Normansrule/hydra-skywater130/docs/CAPACITY.md

# Expansion roadmap, and what each one needs from an FPGA

Generated by `tools/capacity.py` (run it after changing any estimate). Every
"measured" number came out of a tool in this repository or out of the
session-178 place-and-route table; every "est" is an engineering estimate with
its basis stated in the source.

## The conversion, and why it is trustworthy enough to buy a board with

One design, the TT-A v2 tile, mapped three ways in this session:

| mapping | result | tool |
|---|---|---|
| sky130 standard cells | 28,183 cells / 194,647 um2 | yosys + abc |
| Lattice ECP5 LUT4 | 14,360 LUTs, 3,742 flops, 10 multipliers | yosys + nextpnr-ecp5 |
| Xilinx 7-series LUT6 | 7,539 LUTs, 12 DSP48 | yosys synth_xilinx |

So **0.51 ECP5 LUT4** or **0.27 Xilinx LUT6** per sky130 cell, for logic of
this shape. Wide datapaths (the P-256 units, the systolic array) map more
densely than this; register files map worse unless they become block RAM. It
is an order-of-magnitude answer: right for choosing hardware, wrong for
promising a utilisation figure.

| block | sky130 cells | ECP5-85F LUT4 | % of the board |
|---|---|---|---|
| ecdsa_top | 188,028 | 95,805 | 115% |
| tpu_top | 86,591 | 44,120 | 53% |
| mom_top (as the v2 tile) | 28,183 | 14,360 | 17% |
| core_pipe | 24,491 | 12,479 | 15% |
| core_mini | 9,923 | 5,056 | 6% |
| axis blocks (qenc, enc_theta, adc_capture, pwm_gen) | 2,600 | 1,325 | 2% |
| data RAM (flop array) (est) | 135,000 | 68,786 | 82% |

| expansion | sky130 cells (est) | ECP5-85F LUT4 | fits beside the tile? |
|---|---|---|---|

## The roadmap, block by block

| expansion | sky130 cells (est) | ECP5-85F LUT4 | fits beside the tile? |
|---|---|---|---|
| SHE CMAC path | 12,000 | 6,114 | yes |
| trng_source + trng_pool | 6,000 | 3,057 | yes |
| USB protocol engine + CDC | 20,000 | 10,191 | yes |
| engine crossbar (MOM to the engines) | 8,000 | 4,076 | yes |
| RAM ECC (SECDED) + bus fault unit | 10,000 | 5,095 | yes |
| dual-core lockstep | 25,000 | 12,738 | yes |
| RISC-V PMP | 8,000 | 4,076 | yes |
| voltage / temperature / glitch monitors | 4,000 | 2,038 | yes |
| watchdog to safe state | 1,000 | 510 | yes |
| multi-axis motor control, per extra axis | 3,000 | 1,529 | yes |
| 6 axes | 18,000 | 9,171 | yes |
| 20 axes (a humanoid) | 60,000 | 30,572 | yes |
| CAN-FD controller | 15,000 | 7,643 | yes |
| SecOC (authenticated frames) | 6,000 | 3,057 | yes |
| synchronised sensor capture | 4,000 | 2,038 | yes |
| SPI slave / host offload port | 5,000 | 2,548 | yes |
| absolute encoders (BiSS-C or SSI) | 6,000 | 3,057 | yes |
| authenticated debug unlock | 10,000 | 5,095 | yes |
| measured boot and attestation | 8,000 | 4,076 | yes |
| ML-KEM (Kyber) on the NTT | 40,000 | 20,381 | yes |
| PUF key provisioning | 5,000 | 2,548 | yes |
| fault-injection hardening on the signature path | 30,000 | 15,286 | yes |
| camera interface (DVP) | 8,000 | 4,076 | yes |
| Ethernet / TSN MAC | 60,000 | 30,572 | yes |
| GPU (already in the design, size not in the handoff) | 80,000 | 40,762 | yes |

"Fits beside the tile" means it fits in the 69,280 LUTs left over on an
ECP5-85F after the tile takes its 17%.

## The verdict on the ECP5-85F you are buying

board verdicts for the whole SoC:
  iCE40 UP5K (iCEBreaker)                 5,280 LUT4  needs  3279%  does NOT fit   $69
  Gowin GW2AR-18 (Tang Nano 20K)         20,736 LUT4  needs   835%  does NOT fit   $30, Amazon
  Artix-7 35T (Cmod A7)                  20,800 LUT6  needs   437%  does NOT fit   $99, DigiKey
  ECP5-85F (ECP5 Evaluation Board)       83,640 LUT4  needs   207%  does NOT fit   $99-159, DigiKey
  Artix-7 100T (Arty A7-100T)            63,400 LUT6  needs   143%  does NOT fit   ~$299
  Artix-7 200T (Nexys Video)            134,600 LUT6  needs    68%  fits   ~$599
  Kintex-7 325T (Genesys 2)             203,800 LUT6  needs    45%  fits   ~$1,200

**For the tile and for incremental work, the ECP5-85F is the right board.**
The tile uses 17% of it. Any single expansion below fits beside it, and most
pairs do. That is the loop you will actually run: bring a block across, run it
against real latencies, move to the next.

**For the whole SoC at once, it does not fit** — 173,145 LUT4 against 83,640.
Two ways forward, and the first is better:

1. **Feature-gated builds.** One target per subsystem: dispatcher plus cores,
   or crypto alone, or the motor axes plus CAN-FD. Each fits comfortably, each
   runs against real timing, and the gate is a plan file rather than a new
   board. This is also what the eventual chip wants, since a FEATURES register
   telling firmware which blocks exist is needed either way.
2. **A bigger board, when you need the whole thing in one image.** Nexys Video
   (Artix-7 200T, 134,600 LUT6, ~$599) takes the SoC as it stands at 68%.
   Genesys 2 (Kintex-7 325T, 203,800 LUT6, ~$1,200) takes it at 45% and leaves
   room for the roadmap below.

**Heavy duty — everything on this page at once.** The SoC plus the GPU plus the
safety, robotics and security expansions comes to roughly 620,000 cells, which
is about 166,000 LUT6: Genesys 2 at ~81%, nothing cheaper, and an UltraScale+
board if you want headroom. That is a real cost step, and it is the moment to
ask whether one image of everything is worth it, or whether the gated builds
plus the silicon itself answer the same questions.

## Two things that change the arithmetic

- **The data RAM is free on an FPGA.** 0.93 mm2 of flip-flops on the die
  becomes block RAM: the ECP5-85F has 208 x 18 kbit and the design uses none
  of it today. Every FPGA number here already assumes that swap.
- **ECDSA is the whole problem.** 188,028 cells is 55% of the current SoC and
  95,777 LUT4 on its own — more than the ECP5-85F has. Sharing the three
  `p256_modmul` instances down to one (the same arbitration pattern
  `ecdsa_top` already uses) is worth roughly 22,000 cells, and it is the
  single change that most improves both the die and the FPGA story.
