Normansrule/hydra-skywater130/docs/ISA_CPU.md

# CPU instruction set (RV32IM core)

GENERATED by `tools/isa/gen_cpu_isa.py`: every row below is what
`control_unit.sv` DOES when driven with that encoding, recorded by
`tools/isa/isa_probe_cpu.sv`. Do not edit; run the tool.
`make isa-check` fails if this file and the decoder disagree.

**Status: decoder only.** `engines/cpu/rtl/control_unit.sv` is a
control unit, not a CPU core, and nothing here is integrated with the
dispatcher; see `docs/verification/capability-matrix.md`.

55 encodings swept. Columns after `legal` are the decoder's
own control bundle: which ALU operation it selects, which immediate
format it takes, where the writeback comes from, and which unit runs
the instruction.

| instruction | opcode | funct3 | funct7 | legal | writes | ALU op | imm | writeback | unit |
|---|---|---|---|---|---|---|---|---|---|
| `LUI` | `0110111` | — | — | yes | rd | ALU_COPY_B | IMM_U | WB_ALU | ALU |
| `AUIPC` | `0010111` | — | — | yes | rd | ALU_ADD | IMM_U | WB_ALU | ALU |
| `JAL` | `1101111` | — | — | yes | rd | ALU_ADD | IMM_J | WB_PC4 | branch/jump |
| `JALR` | `1100111` | 000 | — | yes | rd | ALU_ADD | IMM_I | WB_PC4 | branch/jump |
| `BEQ` | `1100011` | 000 | — | yes | — | ALU_ADD | IMM_B | WB_ALU | branch/jump |
| `BNE` | `1100011` | 001 | — | yes | — | ALU_ADD | IMM_B | WB_ALU | branch/jump |
| `B?010` | `1100011` | 010 | — | yes | — | ALU_ADD | IMM_B | WB_ALU | branch/jump |
| `B?011` | `1100011` | 011 | — | yes | — | ALU_ADD | IMM_B | WB_ALU | branch/jump |
| `BLT` | `1100011` | 100 | — | yes | — | ALU_ADD | IMM_B | WB_ALU | branch/jump |
| `BGE` | `1100011` | 101 | — | yes | — | ALU_ADD | IMM_B | WB_ALU | branch/jump |
| `BLTU` | `1100011` | 110 | — | yes | — | ALU_ADD | IMM_B | WB_ALU | branch/jump |
| `BGEU` | `1100011` | 111 | — | yes | — | ALU_ADD | IMM_B | WB_ALU | branch/jump |
| `LB` | `0000011` | 000 | — | yes | rd | ALU_ADD | IMM_I | WB_MEM | load |
| `LH` | `0000011` | 001 | — | yes | rd | ALU_ADD | IMM_I | WB_MEM | load |
| `LW` | `0000011` | 010 | — | yes | rd | ALU_ADD | IMM_I | WB_MEM | load |
| `LBU` | `0000011` | 100 | — | yes | rd | ALU_ADD | IMM_I | WB_MEM | load |
| `LHU` | `0000011` | 101 | — | yes | rd | ALU_ADD | IMM_I | WB_MEM | load |
| `SB` | `0100011` | 000 | — | yes | — | ALU_ADD | IMM_S | WB_ALU | store |
| `SH` | `0100011` | 001 | — | yes | — | ALU_ADD | IMM_S | WB_ALU | store |
| `SW` | `0100011` | 010 | — | yes | — | ALU_ADD | IMM_S | WB_ALU | store |
| `ADDI` | `0010011` | 000 | — | yes | rd | ALU_ADD | IMM_I | WB_ALU | ALU |
| `SLTI` | `0010011` | 010 | — | yes | rd | ALU_SLT | IMM_I | WB_ALU | ALU |
| `SLTIU` | `0010011` | 011 | — | yes | rd | ALU_SLTU | IMM_I | WB_ALU | ALU |
| `XORI` | `0010011` | 100 | — | yes | rd | ALU_XOR | IMM_I | WB_ALU | ALU |
| `ORI` | `0010011` | 110 | — | yes | rd | ALU_OR | IMM_I | WB_ALU | ALU |
| `ANDI` | `0010011` | 111 | — | yes | rd | ALU_AND | IMM_I | WB_ALU | ALU |
| `SLLI` | `0010011` | 001 | 0000000 | yes | rd | ALU_SLL | IMM_I | WB_ALU | ALU |
| `SRLI` | `0010011` | 101 | 0000000 | yes | rd | ALU_SRL | IMM_I | WB_ALU | ALU |
| `SRAI` | `0010011` | 101 | 0100000 | yes | rd | ALU_SRA | IMM_I | WB_ALU | ALU |
| `ADD` | `0110011` | 000 | 0000000 | yes | rd | ALU_ADD | IMM_I | WB_ALU | ALU |
| `SUB` | `0110011` | 000 | 0100000 | yes | rd | ALU_SUB | IMM_I | WB_ALU | ALU |
| `SLL` | `0110011` | 001 | 0000000 | yes | rd | ALU_SLL | IMM_I | WB_ALU | ALU |
| `SLT` | `0110011` | 010 | 0000000 | yes | rd | ALU_SLT | IMM_I | WB_ALU | ALU |
| `SLTU` | `0110011` | 011 | 0000000 | yes | rd | ALU_SLTU | IMM_I | WB_ALU | ALU |
| `XOR` | `0110011` | 100 | 0000000 | yes | rd | ALU_XOR | IMM_I | WB_ALU | ALU |
| `SRL` | `0110011` | 101 | 0000000 | yes | rd | ALU_SRL | IMM_I | WB_ALU | ALU |
| `SRA` | `0110011` | 101 | 0100000 | yes | rd | ALU_SRA | IMM_I | WB_ALU | ALU |
| `OR` | `0110011` | 110 | 0000000 | yes | rd | ALU_OR | IMM_I | WB_ALU | ALU |
| `AND` | `0110011` | 111 | 0000000 | yes | rd | ALU_AND | IMM_I | WB_ALU | ALU |
| `MUL` | `0110011` | 000 | 0000001 | yes | rd | ALU_ADD | IMM_I | WB_ALU | mul/div |
| `MULH` | `0110011` | 001 | 0000001 | yes | rd | ALU_ADD | IMM_I | WB_ALU | mul/div |
| `MULHSU` | `0110011` | 010 | 0000001 | yes | rd | ALU_ADD | IMM_I | WB_ALU | mul/div |
| `MULHU` | `0110011` | 011 | 0000001 | yes | rd | ALU_ADD | IMM_I | WB_ALU | mul/div |
| `DIV` | `0110011` | 100 | 0000001 | yes | rd | ALU_ADD | IMM_I | WB_ALU | mul/div |
| `DIVU` | `0110011` | 101 | 0000001 | yes | rd | ALU_ADD | IMM_I | WB_ALU | mul/div |
| `REM` | `0110011` | 110 | 0000001 | yes | rd | ALU_ADD | IMM_I | WB_ALU | mul/div |
| `REMU` | `0110011` | 111 | 0000001 | yes | rd | ALU_ADD | IMM_I | WB_ALU | mul/div |
| `ECALL/EBREAK` | `1110011` | 000 | — | yes | — | ALU_ADD | IMM_I | WB_ALU | ALU |
| `CSRRW` | `1110011` | 001 | — | yes | rd | ALU_ADD | IMM_I | WB_CSR | CSR |
| `CSRRS` | `1110011` | 010 | — | yes | rd | ALU_ADD | IMM_I | WB_CSR | CSR |
| `CSRRC` | `1110011` | 011 | — | yes | rd | ALU_ADD | IMM_I | WB_CSR | CSR |
| `CSRRWI` | `1110011` | 101 | — | yes | rd | ALU_ADD | IMM_I | WB_CSR | CSR |
| `CSRRSI` | `1110011` | 110 | — | yes | rd | ALU_ADD | IMM_I | WB_CSR | CSR |
| `CSRRCI` | `1110011` | 111 | — | yes | rd | ALU_ADD | IMM_I | WB_CSR | CSR |
| `FENCE` | `0001111` | 000 | — | yes | — | ALU_ADD | IMM_I | WB_ALU | ALU |

## Encodings that should be rejected

These are probes, not instructions: each is an encoding RV32IM
does not define. What the decoder does with them is a security
property, because a corrupted or fuzzed instruction stream should
trap rather than execute something.

| probe | opcode | funct3 | funct7 | legal | decoded as |
|---|---|---|---|---|---|
| (bad opcode) | `1111111` | 000 | 0000000 | **no** | rejected |
| (bad load f3) | `0000011` | 111 | 0000000 | yes | load |
| (bad store f3) | `0100011` | 111 | 0000000 | yes | store |
| (bad op f7) | `0110011` | 000 | 0100001 | yes | ALU ALU_SUB |

**3 of 4 undefined encodings decode as legal.**
The decoder checks the opcode but not every reserved funct
field, so an unallocated encoding executes as its nearest
neighbour instead of raising an illegal-instruction trap. On a
chip whose purpose includes security this is worth a decision:
either tighten the decode, or state that trapping is the
privileged-mode monitor's job and test that it happens.
