Normansrule/hydra-skywater130/docs/img/atlas-architecture.dark.png

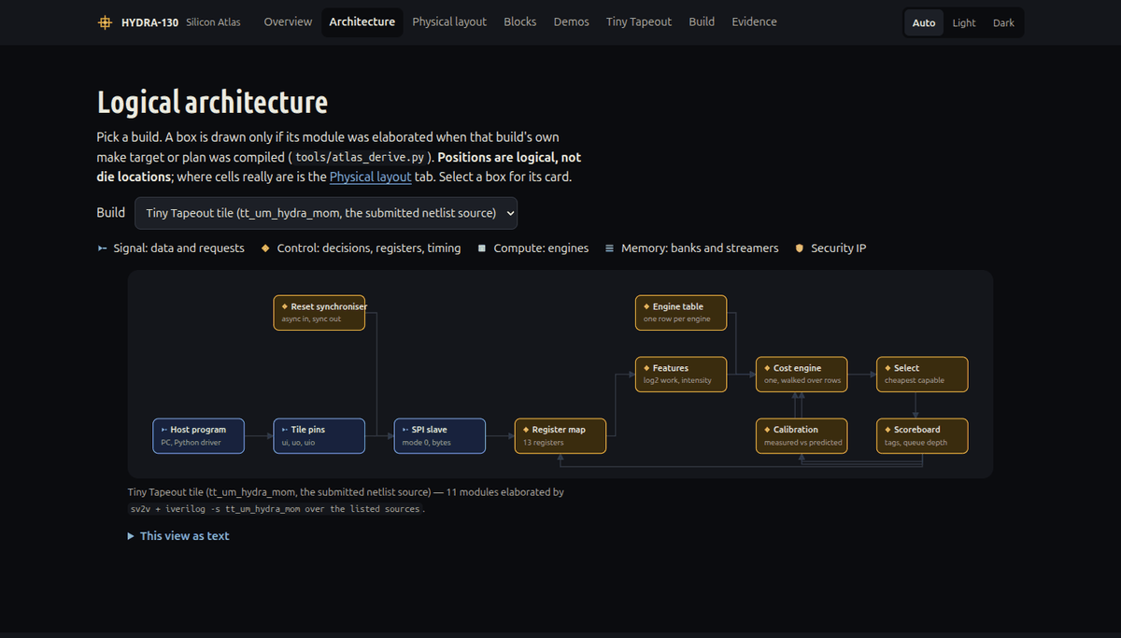
docs/img/atlas-architecture.dark.png
