Normansrule/hydra-skywater130/docs/img/atlas-architecture.png

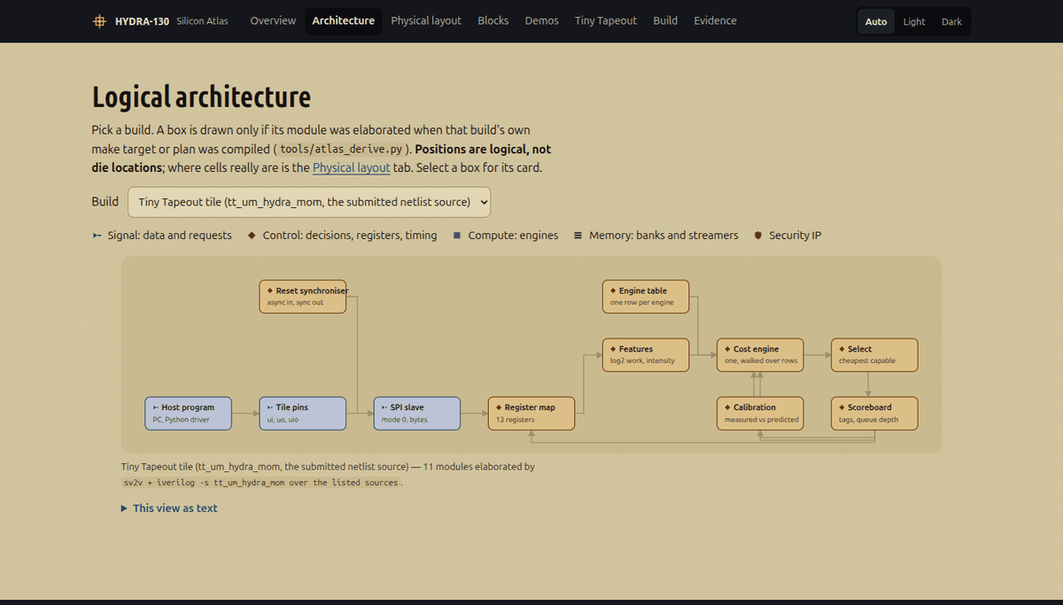
docs/img/atlas-architecture.png
