Normansrule/hydra-skywater130/docs/img/atlas-array.dark.png

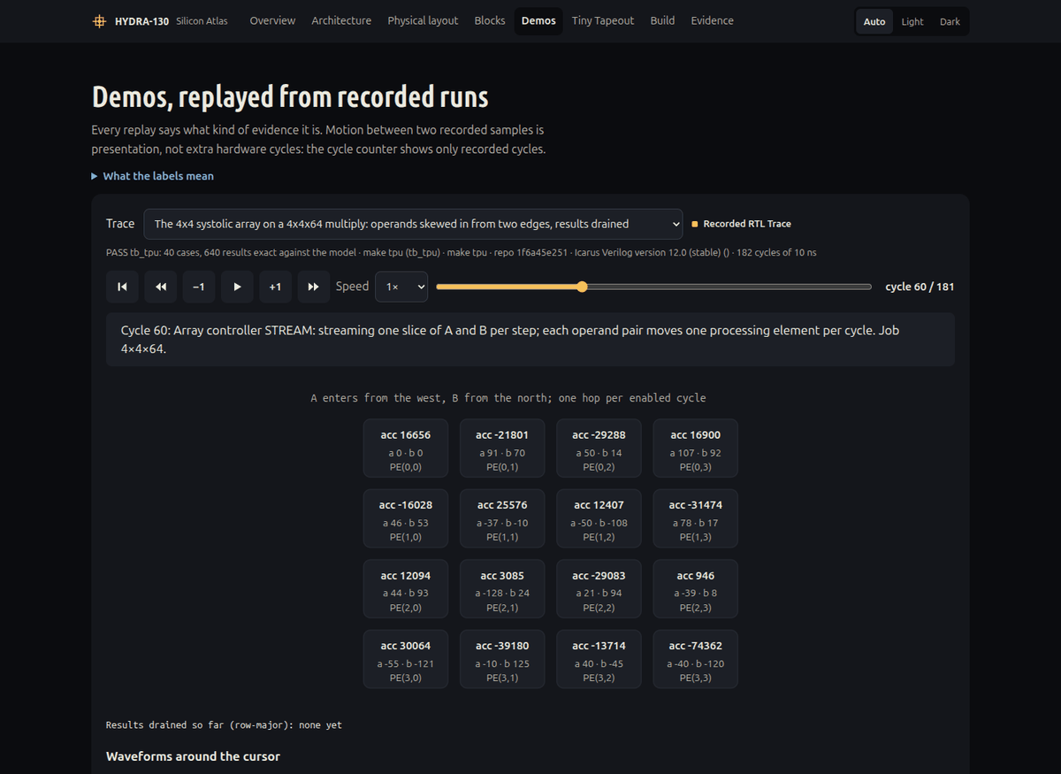
docs/img/atlas-array.dark.png
