Normansrule/hydra-skywater130/docs/img/atlas-array.png

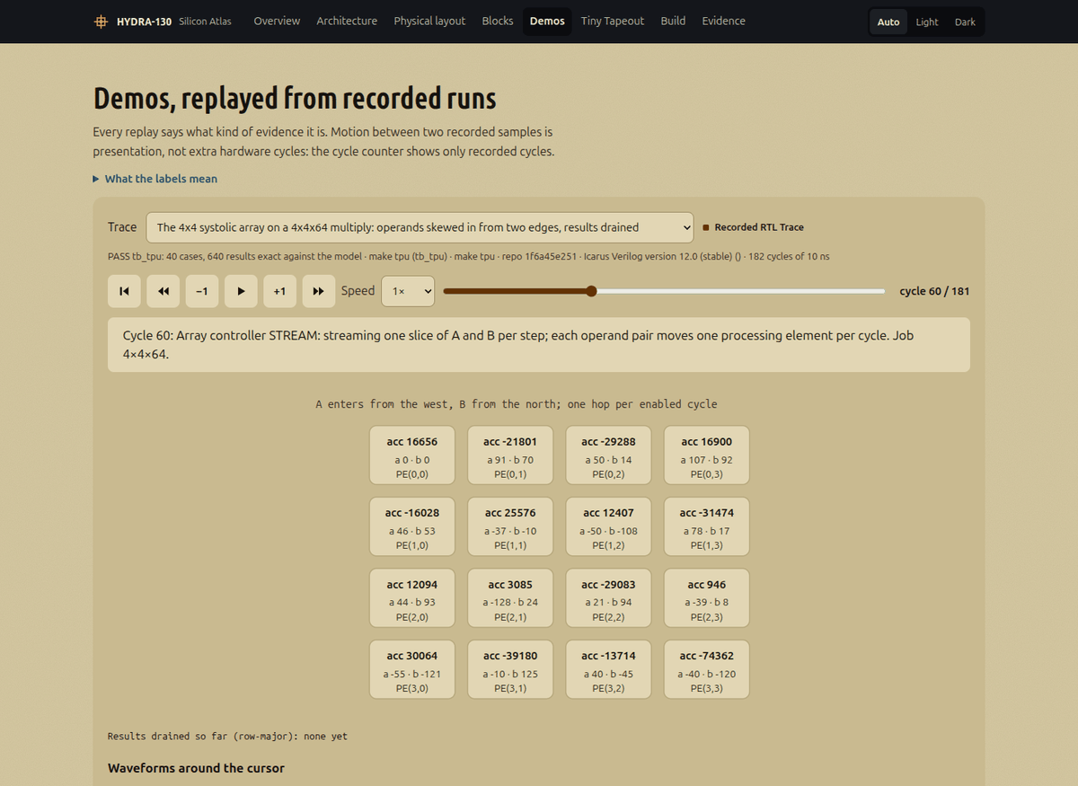
docs/img/atlas-array.png
