Normansrule/hydra-skywater130/docs/img/atlas-demo.dark.png

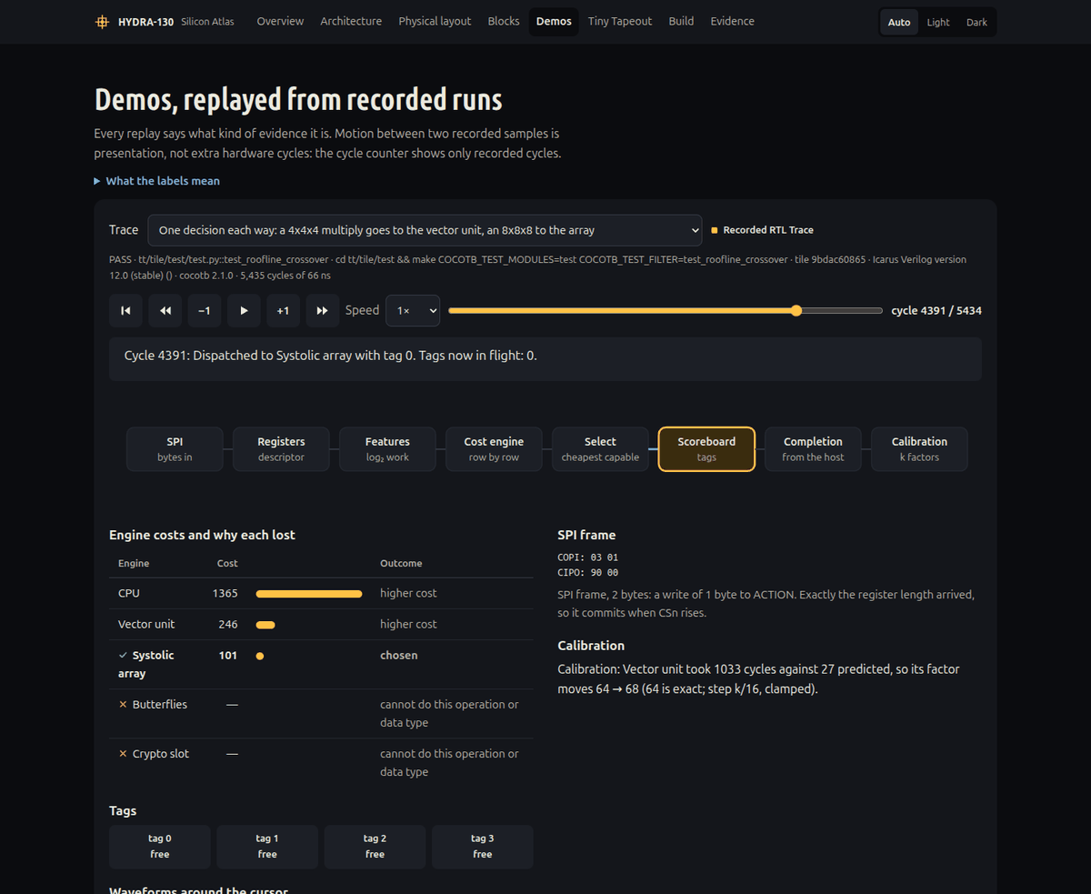
docs/img/atlas-demo.dark.png
