Normansrule/hydra-skywater130/docs/img/atlas-exploded.dark.png

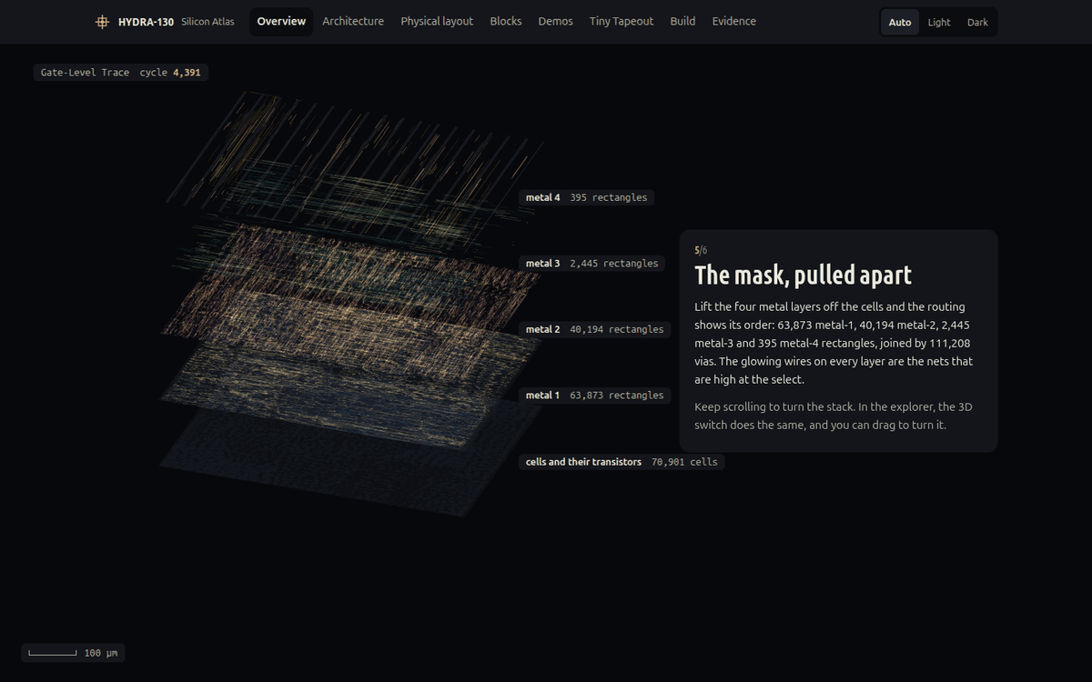
docs/img/atlas-exploded.dark.png
