Normansrule/hydra-skywater130/docs/img/atlas-fpga.dark.png

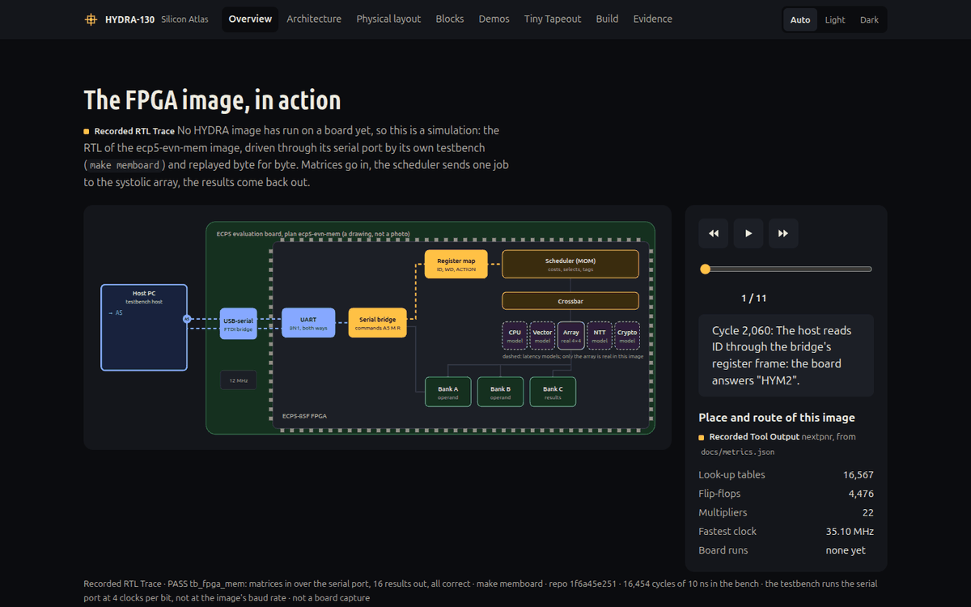
docs/img/atlas-fpga.dark.png
