Normansrule/hydra-skywater130/docs/img/atlas-layout.dark.png

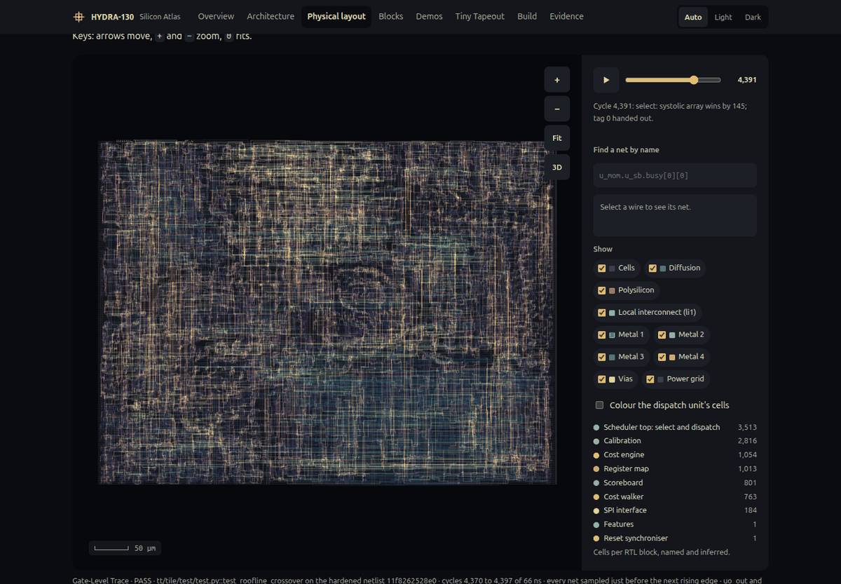
docs/img/atlas-layout.dark.png
