Normansrule/hydra-skywater130/docs/img/atlas-numbers.dark.png

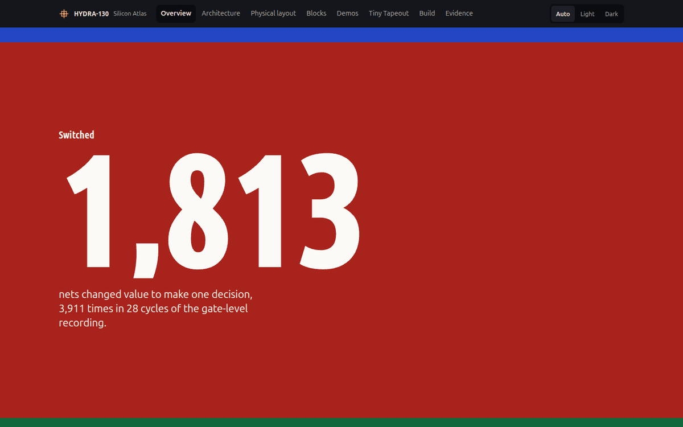
docs/img/atlas-numbers.dark.png
