Normansrule/hydra-skywater130/docs/img/demo_array.dark.gif

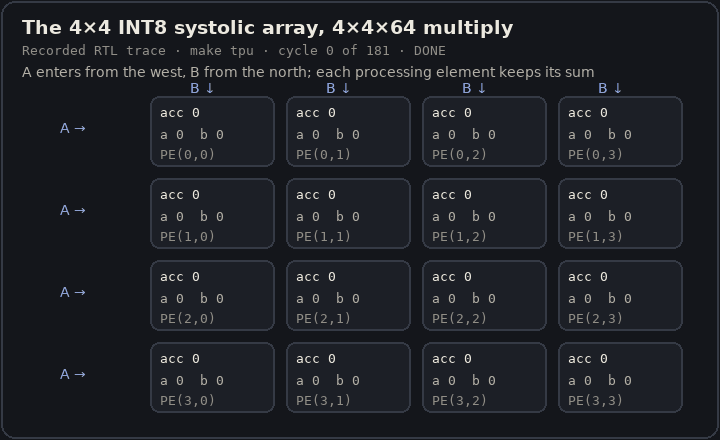
docs/img/demo_array.dark.gif
