Normansrule/hydra-skywater130/docs/img/demo_dispatch.dark.gif

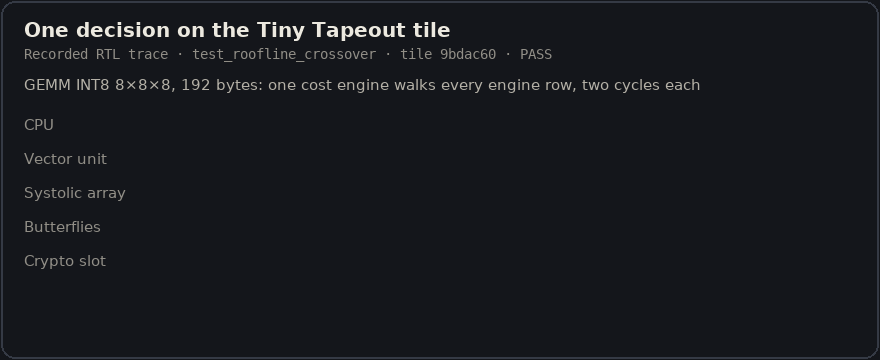
docs/img/demo_dispatch.dark.gif
