Normansrule/hydra-skywater130/docs/img/demo_fpga.dark.gif

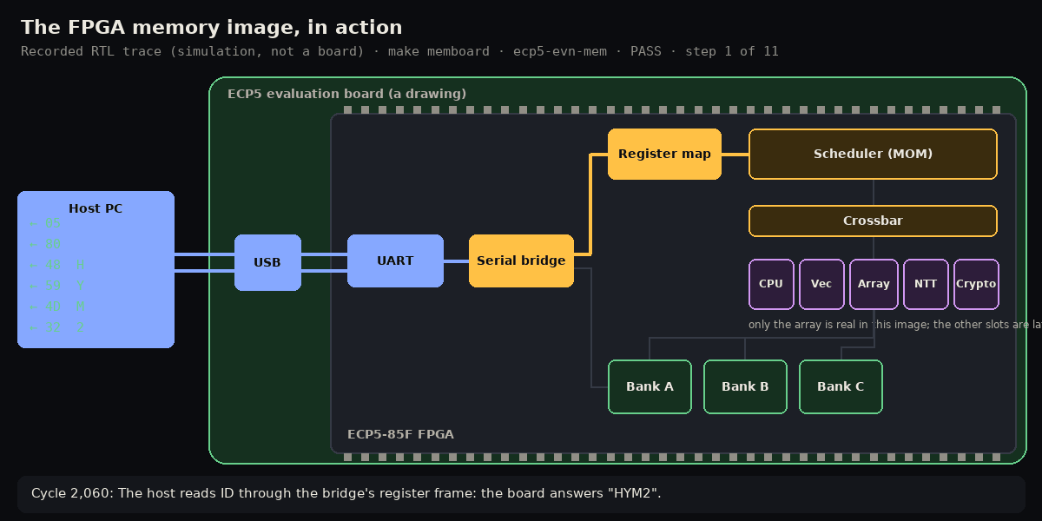
docs/img/demo_fpga.dark.gif
