Normansrule/hydra-skywater130/docs/site/media/array.poster.png

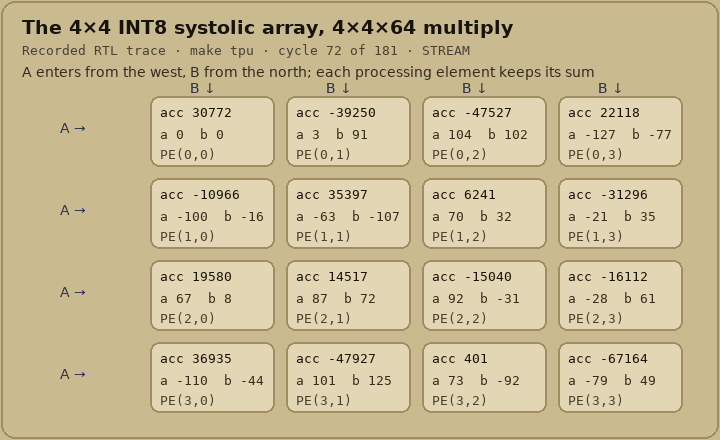
docs/site/media/array.poster.png
