Normansrule/hydra-skywater130/docs/site/media/dispatch.poster.png

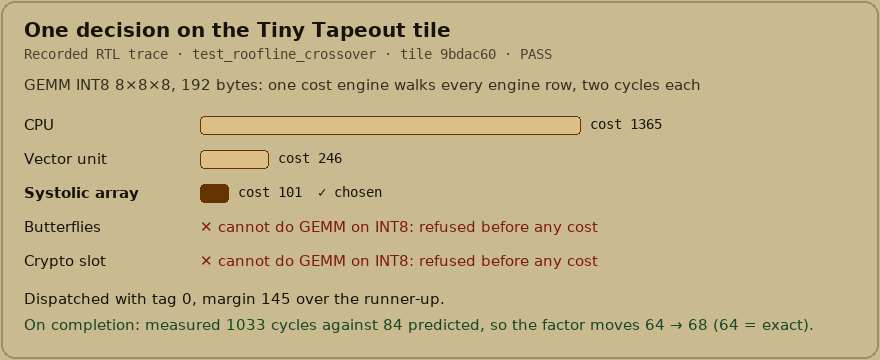
docs/site/media/dispatch.poster.png
