Normansrule/hydra-skywater130/sys/tb/tb_sys_tile_two.sv

// =============================================================================
// tb_sys_tile_two.sv -- the dispatcher choosing between TWO real engines
// =============================================================================
// Same register map, same dispatch path, but engine 2 is the systolic array
// from engines/tpu rather than a latency model. What this must show:
//
//   1. a GEMM descriptor issued through the register map reaches the array,
//      is computed, and retires its tag with no host writing a completion;
//   2. the results are RIGHT -- the running checksum matches
//      sys/tb/tpu_pattern_model.py, which was written from the adapter's
//      contract and knows nothing about the RTL;
//   3. the array's real occupancy back-pressures the dispatcher;
//   4. with the vector unit real as well, each descriptor reaches the
//      engine whose capability mask allows it -- a GEMM to the array, an
//      elementwise vector operation to the lanes -- and both produce results
//      that match their own independent model. This is the dispatcher
//      routing between two pieces of real hardware, which is the whole
//      claim of the project.
//
// Worth stating plainly: the operands are synthetic (a pattern generator
// stands in for the direct memory access engine that does not exist yet).
// The arithmetic, the timing and the dispatch path are real.
// =============================================================================
`timescale 1ns/1ps
`default_nettype none
module tb_sys_tile_two;
  localparam int HALF = 5;

  logic clk = 0, rst_n = 0;
  logic [7:0] ui = 8'b0000_0100;
  wire  [7:0] uo, uio, uio_oe;
  int errors = 0;
  always #27.5 clk = ~clk;
  // A broken design must FAIL here, not hang (ci_selftest, 2026-10-11): about
  // twenty times the cycles a passing run needs.
  initial begin repeat (6000000) @(posedge clk); $display("FAIL tb_sys_tile_two: watchdog"); $fatal(1); end

  hydra_sys_tile #(.TPU_ENGINE(1), .SIMD_ENGINE(1)) dut (
    .ui_in(ui), .uo_out(uo), .uio_in(8'h00), .uio_out(uio), .uio_oe(uio_oe),
    .ena(1'b1), .clk(clk), .rst_n(rst_n));

  // ---- SPI ----------------------------------------------------------------
  logic [7:0] rbuf [24];
  logic [7:0] d [24];
  task automatic xfer(input int n);
    ui[2] = 1'b0;
    repeat (2*HALF) @(posedge clk);
    for (int i = 0; i < n; i++) begin
      logic [7:0] rx;
      for (int b = 7; b >= 0; b--) begin
        ui[1] = d[i][b];
        repeat (HALF) @(posedge clk);
        rx = {rx[6:0], uo[0]};
        ui[0] = 1'b1;
        repeat (HALF) @(posedge clk);
        ui[0] = 1'b0;
      end
      rbuf[i] = rx;
    end
    repeat (HALF) @(posedge clk);
    ui[2] = 1'b1;
    repeat (2*HALF) @(posedge clk);
  endtask
  task automatic wr(input logic [6:0] a, input int n, input logic [127:0] v);
    d[0] = {1'b0, a};
    for (int i = 0; i < n; i++) d[i+1] = v[(n-1-i)*8 +: 8];
    xfer(n+1);
  endtask
  task automatic rd(input logic [6:0] a, input int n, output logic [127:0] v);
    d[0] = {1'b1, a};
    for (int i = 1; i <= n; i++) d[i] = 8'h00;
    xfer(n+1);
    v = '0;
    for (int i = 0; i < n; i++) v = (v << 8) | rbuf[i+1];
  endtask

  // ---- expectations from the model ----------------------------------------
  localparam int NJOB = 5;
  int    jm [NJOB], jn [NJOB], jk [NJOB];
  logic [31:0] jexp [NJOB];

  initial begin
    int fd, code, m, n, k, idx;
    logic [31:0] cs;
    fd = $fopen("sys/tb/tpu_pattern_exp.txt", "r");
    if (fd == 0) begin
      $display("FAIL: run sys/tb/tpu_pattern_model.py first"); $fatal(1);
    end
    idx = 0;
    while (idx < NJOB && !$feof(fd)) begin
      code = $fscanf(fd, "%d %d %d %h\n", m, n, k, cs);
      if (code == 4) begin
        jm[idx] = m; jn[idx] = n; jk[idx] = k; jexp[idx] = cs; idx++;
      end
    end
    $fclose(fd);
  end

  // Reading STATUS over the 4-wire bus takes longer than a 64-deep tile, so
  // polling can never see the array busy. Latch it instead.
  wire tpu_ready_now = dut.g_real_tpu.u_tpu.eng_ready;
  logic tpu_was_busy = 1'b0;
  always_ff @(posedge clk) if (!tpu_ready_now) tpu_was_busy <= 1'b1;

  logic [127:0] v, desc;
  logic [2:0]   eng;
  int j;

  task automatic gemm(input int m, input int n, input int k);
    desc = '0;
    desc[127:124] = 4'd3;         // GEMM
    desc[123:121] = 3'd0;         // INT8
    desc[116:101] = 16'(m);
    desc[100:85]  = 16'(n);
    desc[84:69]   = 16'(k);
    wr(7'h01, 16, desc);
    wr(7'h03, 1, 128'h01);        // ACTION.GO
  endtask

  initial begin
    repeat (5) @(posedge clk); rst_n = 1;
    repeat (20) @(posedge clk);

    // ---- first, the dispatcher is RIGHT to refuse the array -------------
    // At reset the TPU's setup cost is 64 cycles. For a 4x4 tile that dwarfs
    // the work, so the cost model sends the multiply to the cheaper engine
    // and it is correct to do so. The array in this build is 4x4, so it can
    // never receive a tile big enough to earn 64 cycles of setup.
    gemm(4, 4, 4);
    rd(7'h06, 6, v);
    if (v[47:45] === 3'd2) begin
      errors++;
      $display("FAIL: untuned TPU won a 4x4 tile; the cost model should refuse it");
    end else begin
      $display("untuned: 4x4x4 went to engine %0d, not the array (setup cost 64)", v[47:45]);
    end
    for (int w = 0; w < 2000; w++) begin rd(7'h09, 2, v); if (v[15:0] == 0) break; end

    // ---- retune the row so the array is worth using ---------------------
    // PARAM = {2'b0, engine[2:0], p_peak_log2[3:0], t_setup[11:0],
    //          bw_bytes_log2[3:0], eps_op[7:0], dtype_msk[5:0], opc_msk[8:0]}
    // Reset row for the TPU is 7 / 64 / 5 / 2 / 000011 / 000011000; only the
    // setup cost changes here, 64 -> 2, which is what a 4x4 array actually
    // costs to start. This is the register personality doing the job it
    // exists for, against real hardware rather than a model.
    wr(7'h0B, 6, {2'b00, 3'd2, 4'd7, 12'd2, 4'd5, 8'd2, 6'b000011, 9'b000011000});
    $display("retuned the TPU row: setup cost 64 -> 2");

    // Now every GEMM should reach the array, and the results must be right.
    for (j = 0; j < NJOB; j++) begin
      gemm(jm[j], jn[j], jk[j]);
      rd(7'h06, 6, v);
      eng = v[47:45];
      if (eng !== 3'd2) begin
        errors++;
        $display("FAIL job %0d (%0dx%0dx%0d): dispatched to engine %0d, not the TPU",
                 j, jm[j], jn[j], jk[j], eng);
      end
      // wait for the array to finish on its own
      for (int w = 0; w < 6000; w++) begin
        rd(7'h09, 2, v);
        if (v[15:0] == 0) break;
      end
      if (v[15:0] != 0) begin
        errors++;
        $display("FAIL job %0d: tag never retired", j);
      end
      if (dut.g_real_tpu.u_tpu.checksum !== jexp[j]) begin
        errors++;
        $display("FAIL job %0d (%0dx%0dx%0d): checksum %08x, model says %08x",
                 j, jm[j], jn[j], jk[j], dut.g_real_tpu.u_tpu.checksum, jexp[j]);
      end
    end
    if (!errors)
      $display("%0d GEMMs through the register map: every checksum matches the model",
               NJOB);

    // ---- back-pressure: the array is genuinely busy ----------------------
    tpu_was_busy = 1'b0;
    gemm(4, 4, 64);
    for (int w = 0; w < 200; w++) @(posedge clk);
    if (!tpu_was_busy) begin
      errors++;
      $display("FAIL: the array never reported busy during a 64-deep tile");
    end
    for (int w = 0; w < 6000; w++) begin
      rd(7'h09, 2, v);
      if (v[15:0] == 0) break;
    end
    if (dut.g_real_tpu.u_tpu.tiles_done !== 16'(NJOB + 1)) begin
      errors++;
      $display("FAIL: %0d tiles completed, expected %0d",
               dut.g_real_tpu.u_tpu.tiles_done, NJOB + 1);
    end else begin
      $display("back-pressure held, %0d tiles completed", dut.g_real_tpu.u_tpu.tiles_done);
    end

    // ---- the vector unit, on the same dispatcher -------------------------
    begin
      int fd, code, o, red, k, idx;
      logic [31:0] cs;
      int sop [8]; int sred [8]; int sk [8]; logic [31:0] sexp [8];
      fd = $fopen("sys/tb/simd_pattern_exp.txt", "r");
      if (fd == 0) begin
        $display("FAIL: run sys/tb/simd_pattern_model.py first"); $fatal(1);
      end
      idx = 0;
      while (idx < 5 && !$feof(fd)) begin
        code = $fscanf(fd, "%d %d %d %h\n", o, red, k, cs);
        if (code == 4) begin
          sop[idx] = o; sred[idx] = red; sk[idx] = k; sexp[idx] = cs; idx++;
        end
      end
      $fclose(fd);

      for (int q = 0; q < idx; q++) begin
        desc = '0;
        desc[127:124] = sred[q] ? 4'd2 : 4'd1;     // REDUCE or ELEMENT
        desc[123:121] = 3'd2;                      // INT32
        desc[116:101] = 16'(sk[q] * 4);   // element count
        desc[100:85]  = 16'd1;
        desc[84:69]   = 16'd1;
        desc[2:0]     = 3'(sop[q]);                // lane opcode
        wr(7'h01, 16, desc);
        wr(7'h03, 1, 128'h01);
        rd(7'h06, 6, v);
        if (v[47:45] !== 3'd1) begin
          errors++;
          $display("FAIL vector job %0d: went to engine %0d, not the lanes",
                   q, v[47:45]);
        end
        for (int w = 0; w < 4000; w++) begin
          rd(7'h09, 2, v);
          if (v[15:0] == 0) break;
        end
        if (dut.g_real_simd.u_simd.checksum !== sexp[q]) begin
          errors++;
          $display("FAIL vector job %0d (op %0d red %0d k %0d): checksum %08x, model %08x",
                   q, sop[q], sred[q], sk[q],
                   dut.g_real_simd.u_simd.checksum, sexp[q]);
        end
      end
      if (!errors)
        $display("%0d vector jobs: every checksum matches its model, and the GEMMs still went to the array",
                 idx);
    end

    if (errors) begin
      $display("FAIL tb_sys_tile_two: %0d errors", errors); $fatal(1);
    end
    $display("PASS tb_sys_tile_two: the dispatcher routed between two real engines");
    $finish;
  end
endmodule
`default_nettype wire
