Normansrule/hydra-skywater130/fpga/rtl/hydra_fpga_bridge.sv

// =============================================================================
// hydra_fpga_bridge.sv -- PC-side bridge for anything with TinyTapeout pins
// =============================================================================
//
// WHY
//   This is the half of the FPGA harness that has nothing to do with which
//   design is attached: UART in and out, the SPI master, the reset strap and
//   the pin-level command set. It drives anything presenting TinyTapeout
//   pins, so the tile (hydra_fpga_tt_harness) and the full dispatcher-plus-
//   engines system (hydra_fpga_sys_harness) share one bridge instead of two
//   copies that drift apart -- the stale-copy failure this project keeps
//   finding.
//
// HOST PROTOCOL (UART 8N1, default 115200)
//   A5 N d0..dN-1   SPI frame of N bytes (0..32) to the register personality
//                   -> 5A N r0..rN-1          (bytes seen on CIPO)
//   C3 M            reset the tile; M=1 register personality, M=0 legacy
//                   -> 3C M
//   96 U            PIN mode: drive ui_in = U as a level
//                   -> 69 uo_out uio_out      (sampled 4 clocks later)
//   97 U            PIN mode: drive ui_in = U for EXACTLY ONE clock, then
//                   return to the last 96 level. The legacy personality shifts
//                   one bit per clock while `shift` is high, so a level held
//                   across a UART round trip would shift hundreds of bits.
//                   -> 69 uo_out uio_out
//   4D B Ah Al d3..d0  write one 32-bit word to bank B at address A
//                   (memory commands exist only when HAS_MEM = 1; else -> EE)
//                   -> B2 S                    S = 00 written, 01 refused
//                                              (an engine owned the bank)
//   52 Ah Al        read one 32-bit word of the result bank
//                   -> A6 d3 d2 d1 d0          (undefined while a job runs)
//   anything else   -> EE cmd
//
// The tile powers up in the REGISTER personality (DEFAULT_REG = 1) so the PC
// script works with no setup. The strap is applied exactly as a demoboard
// would: ui_in[7:4] = 4'hA with CSn high, held through a 16-cycle reset.
//
// SPI timing matches the cocotb driver that test_regs.py verified: mode 0,
// HALF clocks per half period. HALF defaults to 8, inside the tile's clk/8
// limit with margin for the pin synchroniser.
//
// A SECOND HOST (HAS_JTAG = 1, 2026-10-17)
//   The same command set also arrives as bytes on the jb_* port, from the
//   JTAG test port (hydra_fpga_jtag_host). The command's first byte decides
//   which host owns it: its remaining bytes are taken from that host only,
//   and the reply goes back to that host only, so the two paths never see
//   each other's traffic. A byte from the other host while a command is in
//   progress is dropped, exactly as a UART byte arriving during an SPI frame
//   always has been. If both start a command on the same clock, the UART
//   wins and the JTAG byte is dropped; the JTAG host sees no reply and
//   retries. With HAS_JTAG = 0 the port is ignored and the bridge is the one
//   every earlier image was built and tested with.
// =============================================================================
`default_nettype none

module hydra_fpga_bridge #(
  parameter int CLKS_PER_BIT = 104,
  parameter int HALF         = 8,
  parameter bit DEFAULT_REG  = 1'b1,
  // 1 only when a design with scratchpad memory is attached. Without one, the
  // memory commands are answered EE like any unknown command, rather than
  // acknowledged as if a word had been stored (SkyWater 130 audit HOST-01).
  parameter bit HAS_MEM      = 1'b0,
  parameter bit HAS_JTAG     = 1'b0
) (
  input  logic       clk,
  input  logic       rst_n,         // synchronised board reset
  input  logic       uart_rx_i,
  output logic       uart_tx_o,
  // ---- pins of the attached design ---------------------------------------
  output logic [7:0] ui_in,
  input  logic [7:0] uo_out,
  input  logic [7:0] uio_out,
  output logic       tile_rst_n,

  // ---- scratchpad access ---------------------------------------------------
  // The design under the bridge may have operand memory. Without a way to
  // fill it from the host, a board can only run on data the hardware
  // invented for itself, which is the caveat this port removes.
  output logic        mem_we,
  output logic [1:0]  mem_bank,
  output logic [15:0] mem_addr,
  output logic [31:0] mem_wdata,
  output logic [15:0] mem_raddr,
  input  wire  [31:0] mem_rdata,
  input  wire         mem_refused,   // the design refused the write (it owned the bank)

  // ---- second host: command bytes from the JTAG test port (HAS_JTAG) -------
  input  wire         jb_rx_v,       // one command byte, one clock
  input  wire  [7:0]  jb_rx_d,
  output logic        jb_tx_v,       // one reply byte, one clock
  output logic [7:0]  jb_tx_d,
  input  wire         jb_tx_full,    // the reply queue cannot take a byte

  output logic       reg_mode_o
);

  // ---------------------------------------------------------------------------
  // UART
  // ---------------------------------------------------------------------------
  logic       u_rx_v;
  logic [7:0] u_rx_d;
  logic       rx_v;
  logic [7:0] rx_d;
  logic       tx_start, tx_busy;
  logic [7:0] tx_d;
  logic       src_j;                 // the command in progress came from JTAG

  hydra_fpga_uart_rx #(.CLKS_PER_BIT(CLKS_PER_BIT)) u_rx (
    .clk(clk), .rst_n(rst_n), .rx_i(uart_rx_i), .valid(u_rx_v), .data(u_rx_d));
  hydra_fpga_uart_tx #(.CLKS_PER_BIT(CLKS_PER_BIT)) u_tx (
    .clk(clk), .rst_n(rst_n), .start(tx_start && !src_j), .data(tx_d), .busy(tx_busy),
    .tx_o(uart_tx_o));

  // ---------------------------------------------------------------------------
  // Bridge state
  // ---------------------------------------------------------------------------
  typedef enum logic [3:0] {
    S_IDLE, S_ARG, S_DATA, S_RST, S_PINS, S_CS_LO, S_BIT_SET, S_BIT_HI,
    S_CS_HI, S_REPLY, S_PULSE,
    S_MEM_ARG, S_MEM_WR, S_MEM_ACK, S_MEM_RD, S_MEM_RD_WAIT
  } state_e;
  state_e st;

  logic [7:0]  cmd;
  logic [5:0]  n, idx, arg_base;            // byte count and index (<= 32)
  logic [7:0]  buf_q [32];
  logic [2:0]  bitn;
  logic [15:0] wait_q;
  logic        pin_mode, strap_reg;
  logic [7:0]  pin_ui, pin_level;
  logic        sck, copi, csn;
  logic [5:0]  rep_len, rep_idx;
  logic [7:0]  rep_q [34];
  logic [4:0]  rst_cnt;

  // The byte stream the command decoder reads. Between commands either host
  // may start one (UART first); inside a command only the owner is heard.
  wire j_v     = HAS_JTAG && jb_rx_v;
  wire in_idle = (st == S_IDLE);
  assign rx_v = in_idle ? (u_rx_v || j_v) : (src_j ? j_v : u_rx_v);
  assign rx_d = (in_idle ? !u_rx_v : src_j) ? jb_rx_d : u_rx_d;

  // Replies go back to the owner. The JTAG side has a queue, not a shift
  // register, so its only back-pressure is "full".
  wire tx_free = src_j ? !jb_tx_full : !tx_busy;
  assign jb_tx_v = tx_start && src_j;
  assign jb_tx_d = tx_d;

  // Memory port drive. Address is 16 bits on the wire and the design takes
  // what it needs; the bank is one byte for the same reason -- a wider
  // field costs nothing here and avoids a protocol change later.
  assign mem_we    = (st == S_MEM_WR);
  assign mem_bank  = buf_q[0][1:0];
  assign mem_addr  = {buf_q[1], buf_q[2]};
  assign mem_wdata = {buf_q[3], buf_q[4], buf_q[5], buf_q[6]};
  assign mem_raddr = {buf_q[1], buf_q[2]};

  assign reg_mode_o = strap_reg;

  // Tile pins: reset strap, PIN mode, or SPI from the bridge.
  always_comb begin
    if (rst_cnt != 0)       ui_in = strap_reg ? 8'hA4 : 8'h00;
    else if (pin_mode)      ui_in = pin_ui;
    else if (strap_reg)     ui_in = {5'b0, csn, copi, sck};
    // In the legacy personality the SPI idle pattern must NOT reach the pins:
    // idle chip-select is high, and that pin is legacy's `go`. Leaving it
    // there dispatched whatever was in the shift register the moment reset
    // released (caught by tb_fpga_harness, session 179).
    else                    ui_in = 8'h00;
  end
  assign tile_rst_n = rst_n & (rst_cnt == 0);

  always_ff @(posedge clk or negedge rst_n) begin
    if (!rst_n) begin
      st <= S_IDLE; cmd <= '0; n <= '0; idx <= '0; bitn <= '0; wait_q <= '0;
      arg_base <= 6'd1;
      pin_mode <= 1'b0; strap_reg <= DEFAULT_REG; pin_ui <= '0; pin_level <= '0;
      sck <= 1'b0; copi <= 1'b0; csn <= 1'b1;
      rep_len <= '0; rep_idx <= '0; tx_start <= 1'b0; tx_d <= '0; src_j <= 1'b0;
      rst_cnt <= 5'd16;
      for (int i = 0; i < 32; i++) buf_q[i] <= '0;
      for (int i = 0; i < 34; i++) rep_q[i] <= '0;
    end else begin
      tx_start <= 1'b0;
      if (rst_cnt != 0) rst_cnt <= rst_cnt - 5'd1;

      case (st)
        S_IDLE: if (rx_v) begin
          cmd   <= rx_d;
          src_j <= !u_rx_v;              // UART first if both arrive at once
          if (rx_d == 8'hA5 || rx_d == 8'hC3 || rx_d == 8'h96 || rx_d == 8'h97 ||
              (HAS_MEM && (rx_d == 8'h4D || rx_d == 8'h52))) st <= S_ARG;
          else begin
            rep_q[0] <= 8'hEE; rep_q[1] <= rx_d; rep_len <= 6'd2; rep_idx <= '0;
            st <= S_REPLY;
          end
        end

        S_ARG: if (rx_v) begin
          case (cmd)
            8'hA5: begin
              n   <= (rx_d > 8'd32) ? 6'd32 : rx_d[5:0];
              idx <= '0;
              pin_mode <= 1'b0;
              st  <= (rx_d == 8'd0) ? S_CS_LO : S_DATA;
            end
            8'hC3: begin
              strap_reg <= rx_d[0];
              pin_mode  <= 1'b0;
              csn <= 1'b1; sck <= 1'b0; copi <= 1'b0;
              rst_cnt   <= 5'd16;
              rep_q[0] <= 8'h3C; rep_q[1] <= {7'd0, rx_d[0]};
              st <= S_RST;
            end
            8'h96: begin
              pin_mode  <= 1'b1;
              pin_ui    <= rx_d;
              pin_level <= rx_d;
              wait_q    <= 16'd4;
              st <= S_PINS;
            end
            // 'M': write one scratchpad word.
            //   4D bank ah al d3 d2 d1 d0   ->   B2 00
            8'h4D: begin
              buf_q[0] <= rx_d;          // bank
              n   <= 6'd6;               // address and data still to come
              idx <= '0;
              arg_base <= 6'd1;
              st  <= S_MEM_ARG;
            end
            // 'R': read one word back.
            //   52 ah al   ->   A6 d3 d2 d1 d0
            8'h52: begin
              buf_q[1] <= rx_d;          // address high
              n   <= 6'd1;
              idx <= '0;
              // The remaining byte lands in buf_q[2], NOT buf_q[1]: writing
              // it over the high byte left every read pointing at the low
              // byte's address, so only address zero ever answered
              // correctly. The end-to-end bench found it; the unit benches
              // never exercised this command.
              arg_base <= 6'd2;
              st  <= S_MEM_ARG;
            end
            default: begin              // 8'h97
              pin_mode <= 1'b1;
              pin_ui   <= rx_d;
              st <= S_PULSE;
            end
          endcase
        end

        // Both memory commands collect their remaining bytes here.
        S_MEM_ARG: if (rx_v) begin
          buf_q[arg_base + idx] <= rx_d;
          if (idx + 6'd1 == n) begin
            idx <= '0;
            st  <= (cmd == 8'h4D) ? S_MEM_WR : S_MEM_RD;
          end else begin
            idx <= idx + 6'd1;
          end
        end

        // One cycle of write enable, then acknowledge. The acknowledge
        // matters: a host that streams a thousand words with no reply has
        // no way to notice the one that was dropped.
        S_MEM_WR: begin
          st       <= S_MEM_ACK;
          rep_q[0] <= 8'hB2; rep_q[1] <= 8'h00; rep_len <= 6'd2; rep_idx <= '0;
        end

        // The second acknowledge byte reports whether the design took the
        // word: 00 written, 01 refused because an engine owned the bank
        // (audit R8). The design registers its refusal, so it is valid here.
        S_MEM_ACK: begin
          rep_q[1] <= {7'd0, mem_refused};
          st       <= S_REPLY;
        end

        // The scratchpad registers its read, so the word is valid two
        // cycles after the address is presented; wait_q counts that out
        // rather than assuming a latency.
        S_MEM_RD: begin
          wait_q <= 16'd3;
          st     <= S_MEM_RD_WAIT;
        end

        S_MEM_RD_WAIT: if (wait_q != 0) wait_q <= wait_q - 16'd1;
          else begin
            rep_q[0] <= 8'hA6;
            rep_q[1] <= mem_rdata[31:24];
            rep_q[2] <= mem_rdata[23:16];
            rep_q[3] <= mem_rdata[15:8];
            rep_q[4] <= mem_rdata[7:0];
            rep_len  <= 6'd5; rep_idx <= '0;
            st       <= S_REPLY;
          end

        S_DATA: if (rx_v) begin
          buf_q[idx] <= rx_d;
          if (idx + 6'd1 == n) begin idx <= '0; st <= S_CS_LO; end
          else idx <= idx + 6'd1;
        end

        S_RST: if (rst_cnt == 0) begin
          rep_len <= 6'd2; rep_idx <= '0; st <= S_REPLY;
        end

        S_PULSE: begin                   // pin_ui has been applied for one edge
          pin_ui <= pin_level;
          wait_q <= 16'd4;
          st     <= S_PINS;
        end

        S_PINS: if (wait_q != 0) wait_q <= wait_q - 16'd1;
                else begin
                  rep_q[0] <= 8'h69; rep_q[1] <= uo_out; rep_q[2] <= uio_out;
                  rep_len <= 6'd3; rep_idx <= '0; st <= S_REPLY;
                end

        // ---- SPI master, mode 0 --------------------------------------------
        S_CS_LO: begin
          if (csn) begin csn <= 1'b0; sck <= 1'b0; wait_q <= 16'(2 * HALF); end
          else if (wait_q != 0) wait_q <= wait_q - 16'd1;
          else if (n == 0) begin wait_q <= 16'(HALF); st <= S_CS_HI; end
          else begin
            bitn <= 3'd7; idx <= '0;
            copi <= buf_q[0][7];
            wait_q <= 16'(HALF);
            st <= S_BIT_SET;
          end
        end

        S_BIT_SET: begin                 // COPI valid, SCK low
          if (wait_q != 0) wait_q <= wait_q - 16'd1;
          else begin
            buf_q[idx] <= {buf_q[idx][6:0], uo_out[0]};   // sample CIPO, shift
            sck    <= 1'b1;
            wait_q <= 16'(HALF);
            st     <= S_BIT_HI;
          end
        end

        S_BIT_HI: begin                  // SCK high
          if (wait_q != 0) wait_q <= wait_q - 16'd1;
          else begin
            sck <= 1'b0;
            wait_q <= 16'(HALF);
            if (bitn != 0) begin
              bitn <= bitn - 3'd1;
              copi <= buf_q[idx][7];     // already shifted: next bit is MSB
              st   <= S_BIT_SET;
            end else if (idx + 6'd1 != n) begin
              bitn <= 3'd7;
              idx  <= idx + 6'd1;
              copi <= buf_q[idx + 6'd1][7];
              st   <= S_BIT_SET;
            end else begin
              st <= S_CS_HI;
            end
          end
        end

        S_CS_HI: begin
          if (wait_q != 0) wait_q <= wait_q - 16'd1;
          else if (!csn) begin csn <= 1'b1; wait_q <= 16'(2 * HALF); end
          else begin
            rep_q[0] <= 8'h5A; rep_q[1] <= {2'b0, n};
            for (int i = 0; i < 32; i++) rep_q[i + 2] <= buf_q[i];
            rep_len <= n + 6'd2; rep_idx <= '0;
            st <= S_REPLY;
          end
        end

        S_REPLY: begin
          if (tx_free && !tx_start) begin
            if (rep_idx == rep_len) st <= S_IDLE;
            else begin
              tx_d     <= rep_q[rep_idx];
              tx_start <= 1'b1;
              rep_idx  <= rep_idx + 6'd1;
            end
          end
        end

        default: st <= S_IDLE;
      endcase
    end
  end
endmodule

`default_nettype wire
