Normansrule/hydra-skywater130/(commit log)

2026-09-18 Session 179c: engine crossbar, OpenFrame wrapper, ECP5 eval board, capacity analysis
2026-10-07 Tile complete: sign-off clean at 66 ns, gate-level 17/17; content-hash board builds; verify fails on any failed proof
2026-10-08 CI green: vendor pin files pinned to upstream commits; failures annotated
2026-10-18 v54: tile v3.6 slew fix; GPU engine on a HYDRA bank; visual README
    - tile v3.6: exclude every weak and delay buffer (buf_1, clkbuf_1,
    dlygate4sd*, dlymetal6s*, clkdlybuf4s*). Signed off clean: setup
    +14.836 ns, hold +0.106 ns, 48.9%, slew 4,197 -> 775 (slow corners only),
    capacitance 30 -> 0, gate level 21/21. Recorded in docs/timing.json
    - GPU: Pixelstorm (submodule ext/pixelstorm-gpu @ 4801c8c) behind the engine
    contract on a 4,096-word bank, sys/rtl/hydra_engine_gpu.sv. make gpu: 14
    kernels leave the bank exactly as Pixelstorm's own model predicts; malformed
    launches refused; done only after the last write. 7 GPU mutations caught.
    Synthesized for ECP5: 62,625 LUT4. Not yet a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
2026-10-18 v55: the GPU as the chip's sixth scheduler slot
    - shared dispatcher modules take NENG (default ENG_N = 5); the tile keeps
    five slots and its regenerated netlist is proved equivalent to v3.6's
    (yosys equiv, 7,060 of 7,060 cells)
    - mom_select: the comparator tree was fixed at five lanes; lanes 5 and up
    are now folded in after lane 4 (found by the six-slot bench). Proved
    valid, minimal and low-index ties at 5 and 6 slots (make select-proof);
    the old tree fails the 6-slot proof
    - mom_param_rom: GPU row (nominal: 16 lane-ops/cycle, 128-cycle launch,
    INT32, element/reduce/GEMM); docs/ISA.md regenerated from the RTL
    - hydra_sys_tile: GPU_ENGINE = 1 puts Pixelstorm on slot 5, loaded thro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
2026-10-18 v57: the Sixfold CPU as the chip's CPU slot
    - ext/sixfold-cpu submodule at a642bd6, unchanged; sys/rtl/hydra_engine_cpu.sv
    adds what the core lacked for HYDRA: a host load port, start, done on
    HALTED, a cycle limit, refusal of a launch with no program or a bad entry,
    host writes refused while it runs
    - make cpu: all 24 Sixfold programs give the registers, TOHOST value and
    cycle count of Sixfold's own cycle-exact model (tools/cpu_vectors.mjs)
    - hydra_sys_tile CPU_ENGINE = 1 puts it on slot 0, loaded through the
    control space. make systile-cpu: scalar work goes to the CPU and gives the
    model's registers; scalar forced to the GPU is refused; a GEMM forced to
    the CPU runs there; wi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
2026-10-19 v58: scheduler liveness fix (tile v3.10), cached Sixfold CPU, slew v3.9
    - Scheduler: "queue full" was captured once, when a descriptor was costed,
    and never re-read. A job whose only capable engine was full (five NTT jobs
    on the tile, QMAX 4) waited forever after a tag was retired. The selector
    now masks full engines with the scoreboard's live state and the cost
    register holds a real cost for every capable engine (mom_top, shared by
    tile and chip). New tile test test_full_only_engine_recovers fails on
    v3.8 and passes now; new tile mutation caught by it
    - Tile v3.10 hardened with the v3.6 settings: DRC, LVS, antenna 0; setup
    +14.062 ns, hold +0.105 ns at 66 ns; 48.6%; slew 1,230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
2026-10-19 v59: the Silicon Atlas, an interactive project page built from the RTL, its builds and recorded runs
    - docs/site/index.html becomes the Silicon Atlas: overview with a tour of
    one recorded decision and revision-qualified status; logical views of 18
    builds whose boxes come from the instance tree the compiler elaborated
    (tools/atlas_derive.py); the v3.10 tile's placed cells attributed to RTL
    instances by netlist names only (tools/atlas_physical.py) beside its real
    GDS render; 34 block cards (job, ports, clock and reset, example, failure
    and back-pressure, builds, permalink, evidence, expert view with
    citations); a player replaying 14 traces recorded from passing tests
    (tools/atl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
2026-10-19 v60: re-anchor the reset-synchronizer formal mutations
    v58 split hydra_rst_sync's last stage into rel_q, which left two
    mutations in common/formal/mutate_targets.py pointing at code that no
    longer exists, so make mutate stopped before the other suites ran.
    'release after one edge' now forces rel_q high on the first edge;
    'asynchronous release' now drives rst_n from arst_n. hydra_rst_sync.sby
    kills both. Full make mutate end to end: formal targets all killed,
    mutate_dma 26/26, mutate_mom 32/32, cost mux 4/4, tile mutate_sim 18/18.
2026-10-22 v61: Mask Room atlas. The page opens on the v3.10 tile's routed layout (70,901 cells, 14,608 nets) lit by a gate-level run of one decision on the hardened netlist, pins equal to the RTL trace; an FPG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
2026-10-22 v62: atlas, the fancier pass. Story step 5 pulls the tile's cells and four metal layers apart into a 3D stack that turns with scroll (explorer has the same 3D switch); one number per screen on colour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
